greenhand520/stm32f0_light/models/stm32f0_light_shell_main.stl

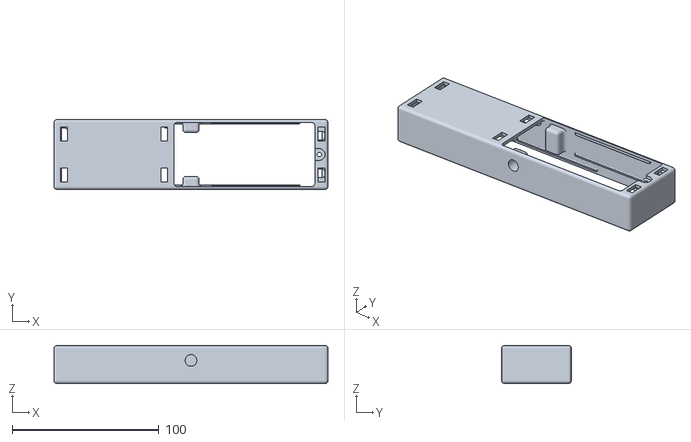
[picture p1: CAD file, 2026-03-17]
models/stm32f0_light_shell_main.stl
187.0 x 47.6 x 26.0
