greenhand520/stm32f0_light/models/stm32_light_shell_battery_cover.stl

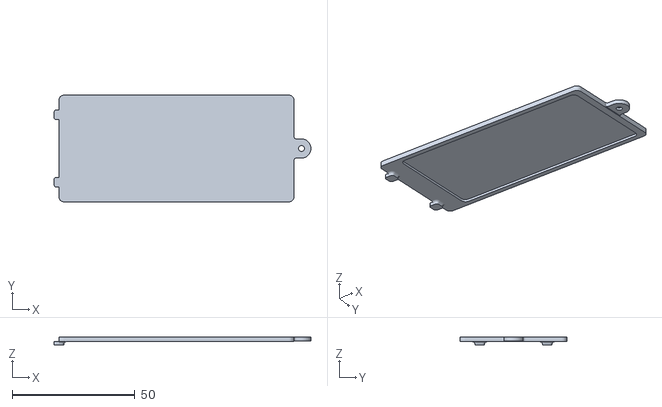
[picture p2: CAD file, 2026-03-17]
models/stm32_light_shell_battery_cover.stl
104.9 x 43.5 x 3.40
