greenhand520/stm32f0_light/models/stm32f0_light_shell_led_cover.stl

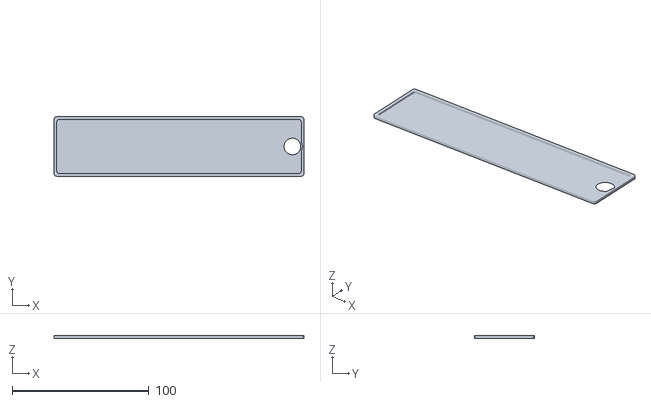
[picture p3: CAD file, 2026-03-17]
models/stm32f0_light_shell_led_cover.stl
183.0 x 43.6 x 2.00
