greenhand520/stm32f0_light/models/stm32f0_light_shell_battery_base.stl

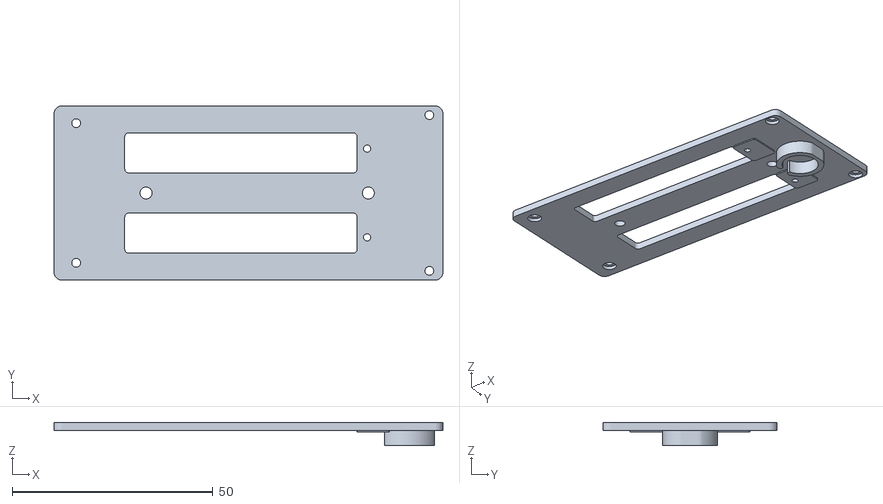
[picture p4: CAD file, 2026-03-17]
models/stm32f0_light_shell_battery_base.stl
96.9 x 43.4 x 5.80
