greenhand520/stm32f0_light/software/stm32f0_light/Core/Inc/main.h

#define STATE_G_Pin GPIO_PIN_0
#define STATE_G_GPIO_Port GPIOF
#define STATE_B_Pin GPIO_PIN_1
#define STATE_B_GPIO_Port GPIOF
#define SYS_WKUP_Pin GPIO_PIN_0
#define SYS_WKUP_GPIO_Port GPIOA
#define BAT_VOLTAGE_ADC_Pin GPIO_PIN_1
#define BAT_VOLTAGE_ADC_GPIO_Port GPIOA
#define BRIGHT_ADC_Pin GPIO_PIN_2
#define BRIGHT_ADC_GPIO_Port GPIOA
#define LED_TEMP_ADC_Pin GPIO_PIN_3
#define LED_TEMP_ADC_GPIO_Port GPIOA
#define FUN_Pin GPIO_PIN_4
#define FUN_GPIO_Port GPIOA
#define CTRL_M_Pin GPIO_PIN_5
#define CTRL_M_GPIO_Port GPIOA
#define CTRL_P_Pin GPIO_PIN_6
#define CTRL_P_GPIO_Port GPIOA
#define Y_PWM_Pin GPIO_PIN_7
#define Y_PWM_GPIO_Port GPIOA
#define STATE_R_Pin GPIO_PIN_1
#define STATE_R_GPIO_Port GPIOB
#define W_PWM_Pin GPIO_PIN_9
#define W_PWM_GPIO_Port GPIOA
#define POWER_MODE_SWITCH_Pin GPIO_PIN_10
#define POWER_MODE_SWITCH_GPIO_Port GPIOA
