greenhand520/stm32f0_light/software/stm32f0_light/BSP/rgb.h

//
// Created by eartholnpc on 2026/3/16.
//

#pragma once

#include <stdint.h>

// low-level lighting
void BSP_RGB_Set(uint8_t r, uint8_t g, uint8_t b);

void BSP_RGB_SetRed(void);
void BSP_RGB_SetGreen(void);
void BSP_RGB_SetBlue(void);
void BSP_RGB_SetWhite(void);
void BSP_RGB_SetYellow(void);
void BSP_RGB_SetPurple(void);
void BSP_RGB_SetOff(void);
