greenhand520/stm32f0_light/(commit log)

2026-10-13 remove old stm32cube project files and model files
2026-10-13 docs: add confirmed requirements for stm32f0_light Rust migration
2026-10-13 feat(logic): add key FSM, PWM math, sensor conversion, settings codec (S1)
2026-10-13 feat(firmware): add HAL init and BSP drivers (S3)
2026-10-13 refactor: rename crate directories to match crate names (light-logic, stm32f0_light)
