greenhand520/stm32f0_light/(notices)

Notices in the files:
software/stm32f0_light/Core/Inc/main.h:
Copyright (c) 2026 STMicroelectronics.
All rights reserved.
This software is licensed under terms that can be found in the LICENSE file
